CRM-UAM/coche-RC/README.md

# coche-RC
Proyecto para controlar y automatizar el coche grande todo terreno.

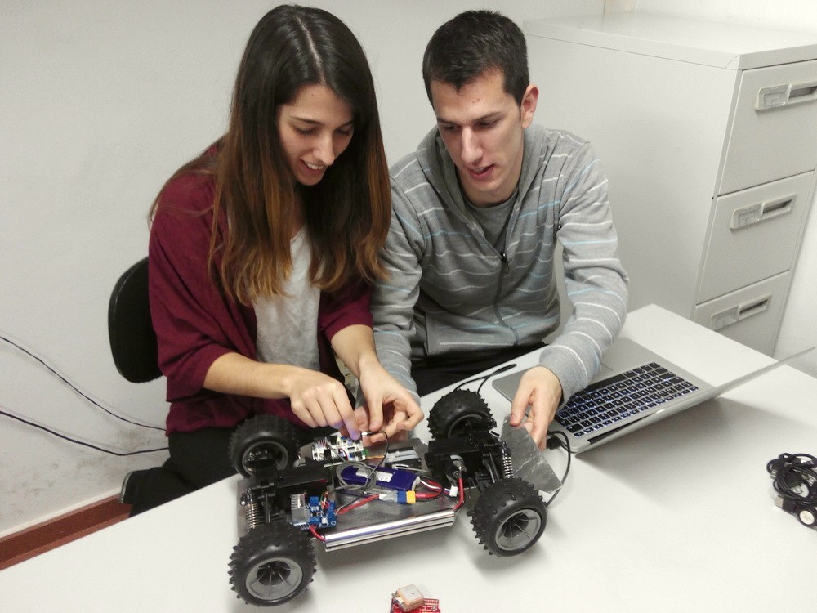
[picture p1: fotos/2016-02-05 12.49.50.jpg]


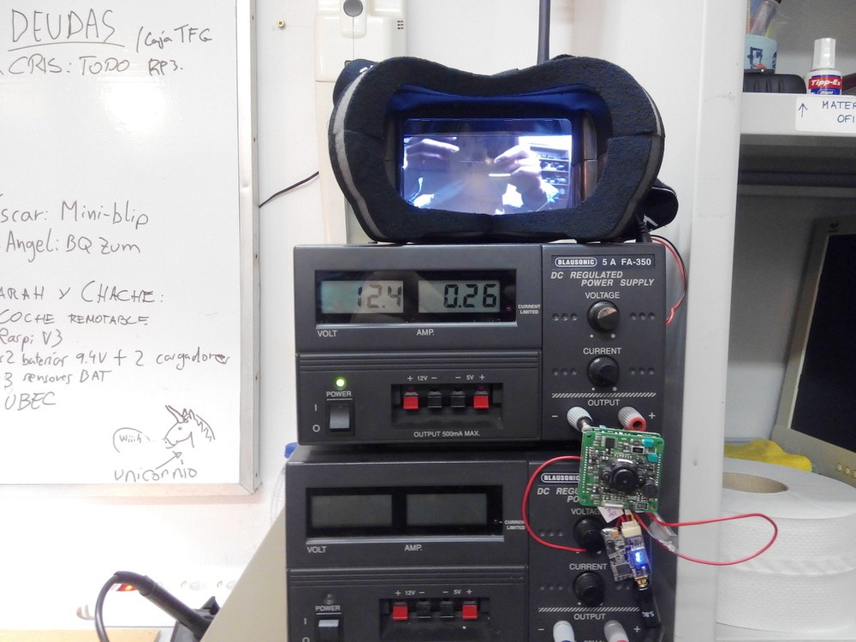
[picture p2: fotos/2016-05-24 14.00.58.jpg]


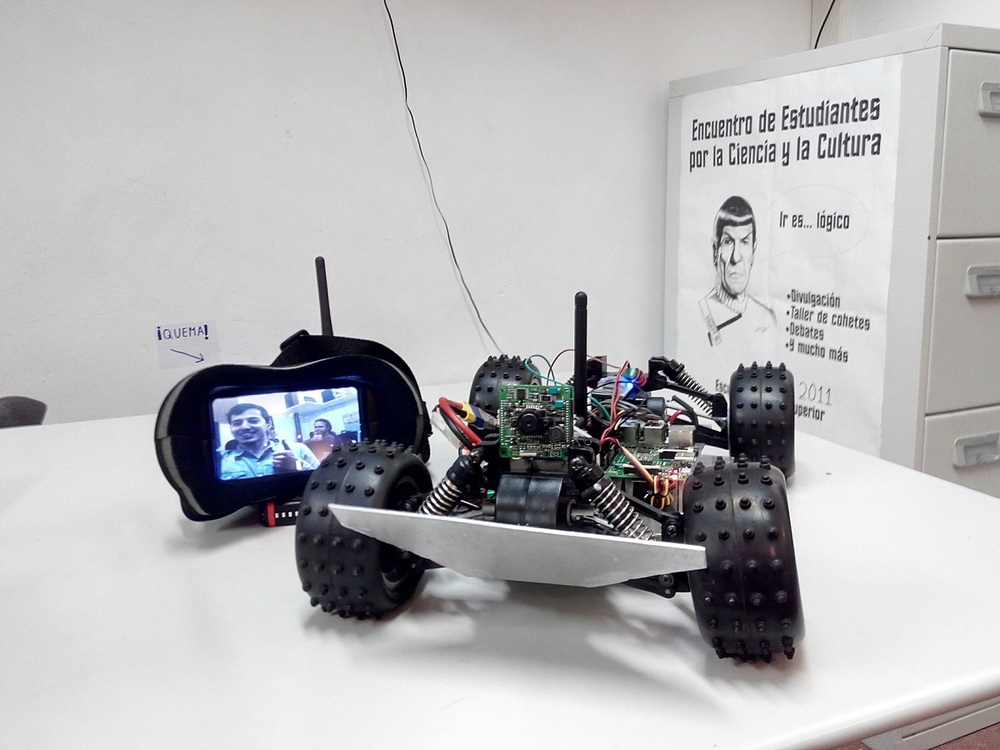
[picture p3: fotos/2016-05-24 18.41.45.jpg]


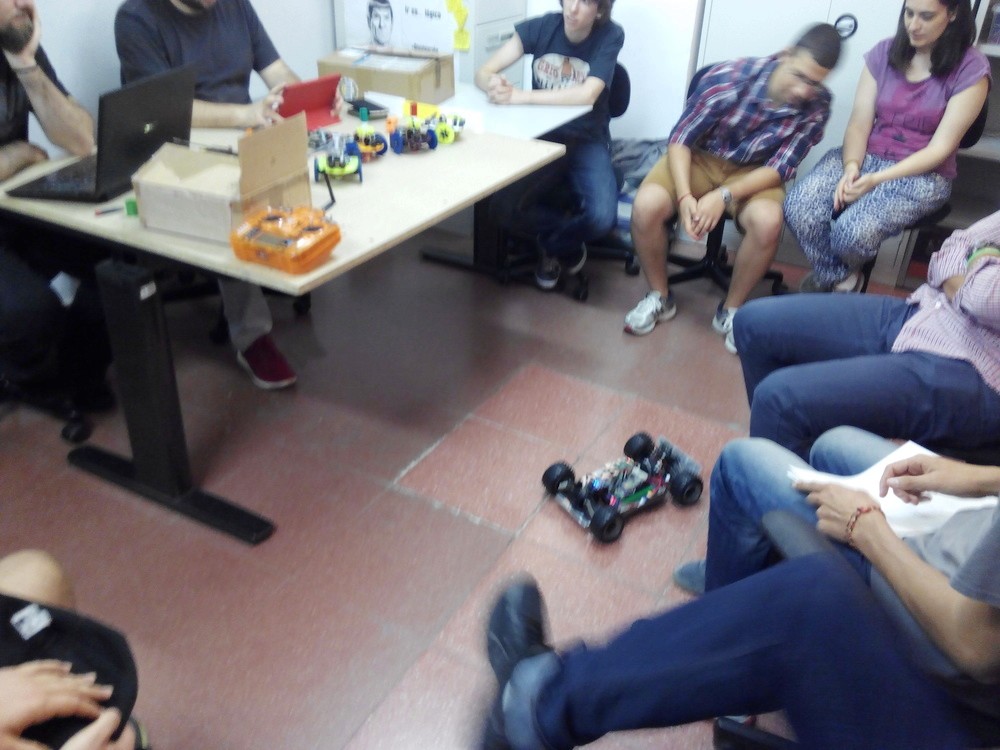
[picture p4: fotos/2016-09-28 13.52.47.jpg]


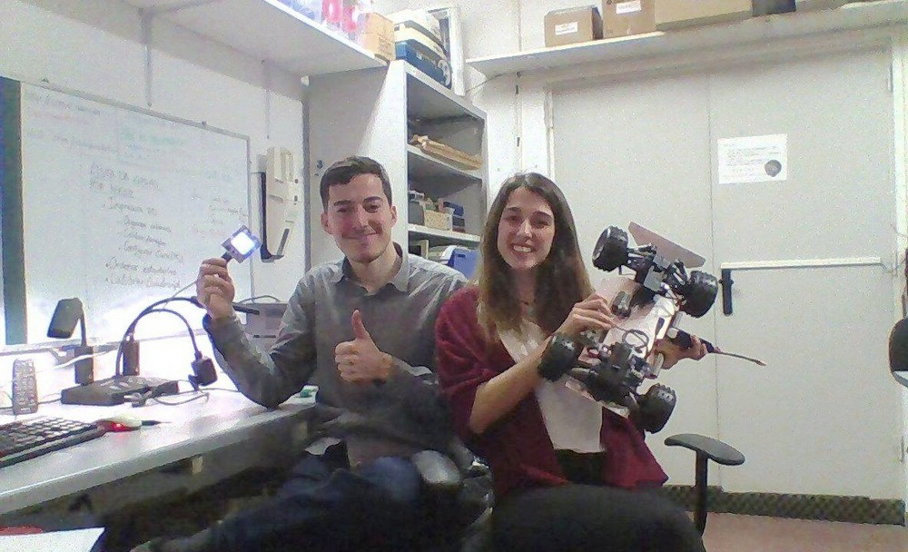
[picture p5: fotos/IMG_20160205_220530.jpg]
