CRM-UAM/coche-RC/Sarah_Carlos/00_configuracion_RaspberryPi3/README

sudo apt-get update
sudo apt-get upgrade

sudo apt-get install isc-dhcp-server

# configurar los archivos
sudo update-rc.d isc-dhcp-server enable

# por un bug, hay posibilidades de que se llene 
# la SD rapidamente
# https://www.raspberrypi.org/forums/viewtopic.php?f=63&t=134971#p898539
# solucion: comentar 4 lineas en /etc/rsyslog.conf

# -->
# ********** Commenting out the next 4 lines *********
#daemon.*;mail.*;\
#       news.err;\
#       *.=debug;*.=info;\
#       *.=notice;*.=warn       |/dev/xconsole
