CRM-UAM/coche-RC/Sarah_Carlos/03_client/img/arrows/128/blue_arrow.png

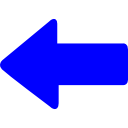
Sarah_Carlos/03_client/img/arrows/128/blue_arrow.png
