CRM-UAM/coche-RC/Sarah_Carlos/03_client/img/arrows/128/white_arrow.png

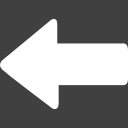
Sarah_Carlos/03_client/img/arrows/128/white_arrow.png
