CRM-UAM/coche-RC/Sarah_Carlos/03_client/img/car/base.png

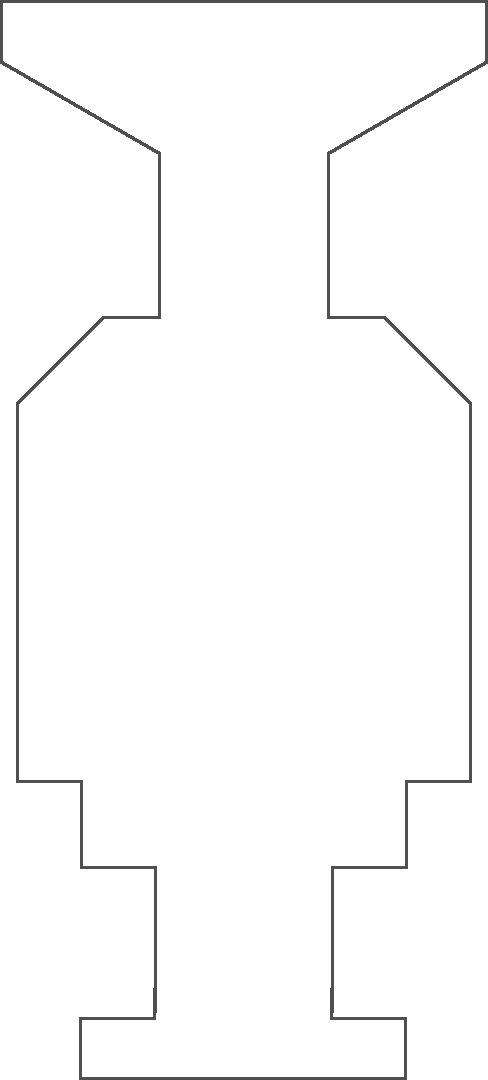
Sarah_Carlos/03_client/img/car/base.png
