CRM-UAM/coche-RC/Sarah_Carlos/04_piezas/soporte_sensor_derecha.stl

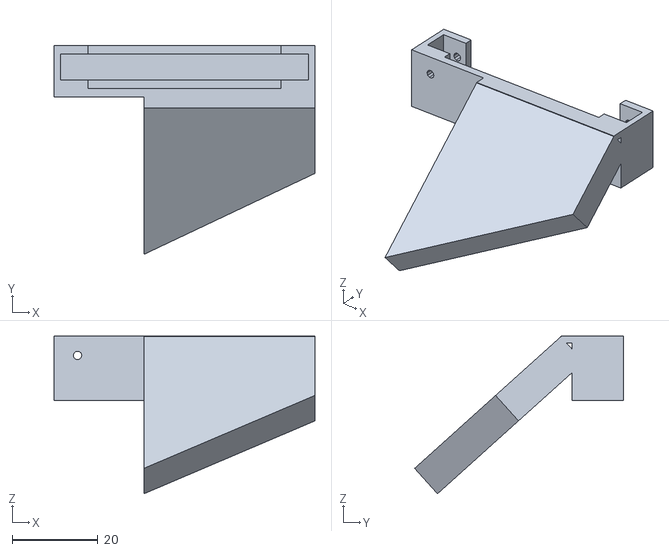
[picture p19: CAD file, 2016-05-23]
Sarah_Carlos/04_piezas/soporte_sensor_derecha.stl
61.0 x 48.8 x 36.8
