CRM-UAM/coche-RC/(list of files, cad)

Other CAD files:
Sarah_Carlos/04_piezas/soporte_sensor_izquierda.stl
