CRM-UAM/coche-RC/(commit log)

2016-02-05 codigo incial con funciones basicas para control la traccion y la direccion
2016-02-09 Prueba del modulo GPS de sparkfun
2016-04-03 Configuracion de la raspi para red Wifi ad-hoc
2016-05-23 Añadida toda la entrega de PSEM
    [soporte_sensor.scad, soporte_sensor_derecha.stl, soporte_sensor_izquierda.stl]
2016-05-24 Modificado para que funcione para los propositos del CRM
2022-12-12 Enlazadas las fotos para que se vean en el README :)
